AndrewFrelas/Standalone-ESP32-C3-SuperMini-HU058NtpClock-Based-on-Repo-from-misterblack1/docs/4Yq_GvgGTxWyM-0vjenwmw.jpg

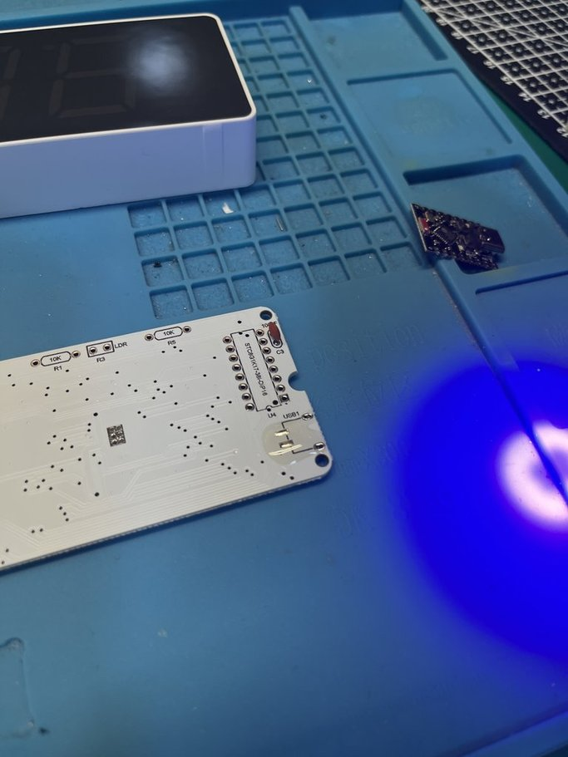
docs/4Yq_GvgGTxWyM-0vjenwmw.jpg
