AndrewFrelas/Standalone-ESP32-C3-SuperMini-HU058NtpClock-Based-on-Repo-from-misterblack1/docs/n2SkAXRnT0eoZViO6scS3w.jpg

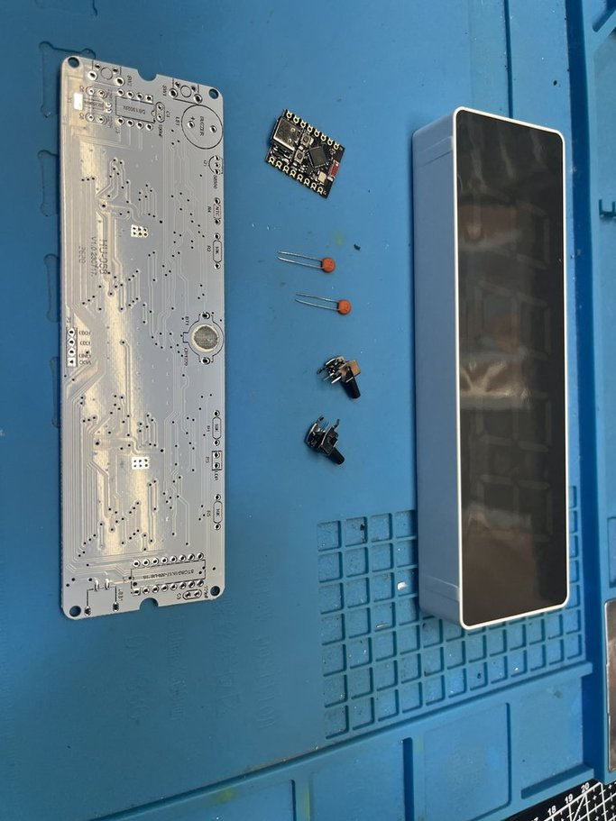
docs/n2SkAXRnT0eoZViO6scS3w.jpg
